Clairechen425/embedded-course-case8/docs/中期检查报告.md

# 中期检查报告

**项目名称**：基于手势识别的智能风扇控制系统  
**报告日期**：2026-07-05  
**小组成员**：3124009587 关博仁、3224004799 陈佩欣

---

## 一、物料到位总览

### 1.1 已到位的物料

| 序号 | 物料名称 | 型号/规格 | 数量 | 用途 | 到位状态 |
|---|---|---|---|---|---|
| 1 | Orange Pi AIpro | 开发板 | 1 | 上位机，运行 HaGRID YOLO 手势识别推理 | 已到位 |
| 2 | STM32F103C8T6 | 最小系统板 | 1 | 下位机，接收手势指令并控制执行器 | 已到位 |
| 3 | USB 摄像头 | 免驱 USB | 1 | 实时手势图像采集 | 已到位 |
| 4 | SG90 舵机 | 9g 微型舵机 | 2 | 云台左右/上下摆风 | 已到位 |
| 5 | L298N 驱动模块 | 双 H 桥 | 1 | 130 直流电机驱动 | 已到位 |
| 6 | 130 直流电机 + 风扇叶片 | 3-6V | 1 | 风源输出 | 已到位 |
| 7 | 充电宝 | 5V/2A 输出 | 1 | 系统统一供电 | 已到位 |
| 8 | USB 数据线 | Micro-USB + Type-C | 2 | Pi↔STM32 通信、Pi↔摄像头连接 | 已到位 |

### 1.2 未到位的物料

| 序号 | 物料名称 | 原因 | 影响 | 预计到位时间 |
|---|---|---|---|---|
| — | 无 | — | — | — |

> **结论**：全部物料已到位，无缺料风险。

---

## 二、当前完成进度

### 2.1 已完成工作

| 序号 | 工作内容 | 负责人 | 完成时间 | 备注 |
|---|---|---|---|---|
| 1 | 硬件系统搭建与连线 | 全组 | 前期 | STM32 + L298N + 电机 + 双舵机 + 摄像头全部连通 |
| 2 | 引脚分配与 PWM 参数确定 | 全组 | 前期 | 风扇 TIM3 CH1 (PA6, 1kHz)、舵机 TIM4 CH1/CH2 (PB6/PB7, 50Hz) |
| 3 | USB CDC 通信链路打通 | 软件组 | 前期 | Pi → STM32 JSON 行协议通信正常 |
| 4 | 极简 JSON 解析器 | 软件组 | 前期 | 手写 `json_get_int/float/str` 三个函数，不依赖外部库 |
| 5 | 风扇四档 PWM 调速 | 软件组 | 前期 | 1 档 (25%) / 2 档 (50%) / 3 档 (75%) / 4 档 (100%) |
| 6 | 手势名称映射表 | 软件组 | 前期 | 34 类手势名称与 Python 端对齐 |
| 7 | Pi 端 3 帧消抖机制 | 软件组 | 前期 | GestureDebouncer 类，threshold=3，确认后去重 |
| 8 | PC 端模拟通信测试 | 软件组 | 前期 | PowerShell 直写 COM 口，全部手势指令验证通过 |
| 9 | 手势识别模型部署 | 软件组 | 前期 | HaGRID YOLO 模型在 Orange Pi 上 10Hz 推理 |

### 2.2 进行中工作

| 序号 | 工作内容 | 当前进展 | 剩余工作 | 预计完成 |
|---|---|---|---|---|
| 1 | 双舵机摆风控制 | 已完成上下舵机独立扫描逻辑设计（预判式折返算法），正在 STM32 端集成调试 | TIM4 初始化、主循环中舵机扫描代码集成、联调 | 2026-07-10 |
| 2 | 左右舵机端点卡顿修复 | 已从"先加后判"改为"预判式折返"方案，边界弹离逻辑已设计 | 实际硬件验证预判式方案是否消除端点停顿 | 2026-07-10 |
| 3 | 全关机联动逻辑 | 代码逻辑已设计（fist → 风扇停 + 双舵机回中） | STM32 端集成测试 | 2026-07-12 |

### 2.3 未开始工作

| 序号 | 工作内容 | 说明 |
|---|---|---|
| 1 | 摄像头设备号漂移修复 | 需通过 udev 规则或设备序列号固定 `/dev/videoX` |
| 2 | 130 电机过热保护 | 需在 4 档加入 PWM 软限幅或温控降档逻辑 |
| 3 | 整机联调测试 | Pi + STM32 + 执行器全链路手势控制实测 |
| 4 | 外壳/结构固定 | 云台、电机、开发板的物理固定与走线整理 |
| 5 | 异常恢复机制 | USB 断连重连、手势超时自动待机等 |
| 6 | 验收文档与演示准备 | 演示脚本、操作说明、项目总结 |

---

## 三、硬件调试情况

### 3.1 各模块测试结果

| 模块 | 测试内容 | 测试方法 | 测试结果 | 状态 |
|---|---|---|---|---|
| STM32 最小系统 | 时钟、GPIO、定时器初始化 | STM32CubeMX 生成 HAL 工程，HSE 8MHz → PLL 48MHz | 正常运行 | 通过 |
| USB CDC 通信 | Pi → STM32 数据传输 | Pi 端发送 `{"c":21,"n":"peace","s":0.95}` → STM32 解析后 PC13 LED 闪烁 | 通信稳定，无丢包 | 通过 |
| L298N + 130 电机 | 风扇四档调速 | 串口发送档位指令 → TIM3 PWM → L298N ENA → 电机转速变化 | 四档转速明显区分 | 通过 |
| SG90 舵机 #1 (PB6) | 左右摆风 | 50Hz PWM, CCR 250–1250 对应 0°–180° | 摆动正常，端点有卡顿（见 3.2） | 部分通过 |
| SG90 舵机 #2 (PB7) | 上下摆风 | 50Hz PWM, 独立 tick 控制 | 摆动正常 | 通过 |
| 双舵机协同 | 两轴同时扫描 | 独立 tick 避免互锁 | 节奏无干扰 | 通过 |
| USB 摄像头 | 图像采集 | Orange Pi 上 OpenCV 读取 | 正常，但 /dev/videoX 编号漂移 | 部分通过 |
| Orange Pi AIpro | 10Hz 推理 | HaGRID YOLO 模型 | 10fps 稳定 | 通过 |
| 充电宝供电 | 全系统供电稳定性 | 同时带 Pi + STM32 + L298N + 双舵机 | 正常工作 | 通过 |

### 3.2 遇到的问题与解决措施

| 编号 | 问题描述 | 现象 | 原因分析 | 解决措施 | 状态 |
|---|---|---|---|---|---|
| HW-1 | 左右舵机单侧端点卡顿 | 一端折返丝滑，另一端肉眼可见停顿一个 tick | 旧方案"先加 CCR 再判断越界"，导致舵机在边界值上停留一个周期 | 改为"预判式折返"：先计算 `next = ccr + dir * 2`，若越界则当场计算反弹值，不写边界 CCR | 方案已设计，待硬件验证 |
| HW-2 | 摄像头设备号漂移 | 每次重启后 `/dev/videoX` 编号变化（video0/video1/video2） | Linux 内核枚举 USB 设备的顺序不确定 | 方案 A: 通过 `/dev/v4l/by-id/` 符号链接固定；方案 B: udev 规则绑定设备序列号创建 `/dev/camera` 别名 | 待实施 |
| HW-3 | 130 电机 5V 全速过热 | 4 档 (100% PWM) 持续运行时电机散发焦味 | 130 电机额定电压 3-6V，满占空比长期运行超出散热能力 | 方案 A: 4 档 PWM 软限幅至 85%；方案 B: 加入超时自动降档（连续 4 档 30s → 降至 2 档） | 待实施 |
| HW-4 | 杜邦线接触不良 | 偶发舵机抖动 | 杜邦线插接不可靠 | 用热熔胶固定关键接口，或更换焊接式连接 | 待处理 |

---

## 四、软件调试情况

### 4.1 各功能模块开发进度

#### Pi 端（上位机）

| 模块 | 文件 | 功能 | 进度 | 说明 |
|---|---|---|---|---|
| 手势识别推理 | `hagrid_yolo/` | HaGRID YOLO 模型推理，10Hz | 100% | 基于官方 demo 运行 |
| 消抖发送 | `camera.py` | `GestureDebouncer` 类：3 帧连击确认 + 确认后去重 | 100% | threshold=3，约 300ms 响应延迟 |
| USB 发送器 | `scripts/usb_sender.py` | `USBSender` 类：JSON 行协议，通过 pyserial 发送到 `/dev/stm32` | 100% | 含 100ms 最小间隔 + score<0.5 过滤 |
| 摄像头固定 | — | 解决 /dev/videoX 漂移 | 0% | 待实施 |

#### STM32 端（下位机）

| 模块 | 文件 | 功能 | 进度 | 说明 |
|---|---|---|---|---|
| USB CDC 接收 | `usbd_cdc_if.c` | `CDC_Receive_FS`：按 `\n` 分行，逐字节累积 | 100% | 含 `ReceivePacket` 重新注册 |
| JSON 解析 | `usbd_cdc_if.c` | `json_get_int/float/str` 三个手写函数 | 100% | 不依赖外部库，适配 20KB RAM |
| 手势数据结构 | `gesture.h` | `GestureResult` 结构体 + 全局变量声明 | 100% | 含 class_id, class_name, score, bbox |
| 手势名称表 | `gesture.c` | `GESTURE_NAMES[34]` 数组 | 100% | 与 Python 端 NAMES 对齐 |
| 风扇 PWM 控制 | `main.c` | switch-case 手势→PWM 档位映射 | 100% | 5 组映射覆盖 12 种手势 ID |
| 接收反馈 LED | `main.c` | 收到手势→PC13 亮 100ms | 100% | 便于调试 |
| 双舵机摆风控制 | `main.c` | 预判式折返 + 独立 tick + OK/timeout/like/dislike 手势映射 | 70% | 算法已设计，main.c 集成未完成 |
| 全关机联动 | `main.c` | fist → 风扇停 + 双舵机回中 | 60% | 逻辑已设计，待舵机代码集成后联调 |

### 4.2 已通过的测试用例

| 编号 | 测试项 | 测试方法 | 预期结果 | 实际结果 | 状态 |
|---|---|---|---|---|---|
| TC-1 | USB CDC 通信链路 | Pi 端发送 JSON → STM32 PC13 LED 闪烁 | LED 每次接收后闪烁 100ms | LED 正常闪烁 | 通过 |
| TC-2 | 风扇 1 档 | one 手势 (ID=19) | PWM CCR=250, 25% 占空比 | 电机低速运转 | 通过 |
| TC-3 | 风扇 2 档 | peace 手势 (ID=21) | PWM CCR=500, 50% 占空比 | 电机中速运转 | 通过 |
| TC-4 | 风扇 3 档 | three 手势 (ID=26) | PWM CCR=750, 75% 占空比 | 电机高速运转 | 通过 |
| TC-5 | 风扇 4 档 | four 手势 (ID=15) | PWM CCR=999, 100% 占空比 | 电机全速运转 | 通过 |
| TC-6 | 开机 (palm) | palm 手势 (ID=20) | 风扇启动 | 风扇启动 | 通过 |
| TC-7 | 全关机 (fist) | fist 手势 (ID=14) | PWM CCR=0, 电机停止 | 电机停止 | 通过 |
| TC-8 | 左右摆风开 | ok 手势 (ID=18) | 舵机 #1 开始扫描 | 舵机摆动 | 部分通过 |
| TC-9 | 左右摆风关 | timeout 手势 (ID=6) | 舵机 #1 停止并回中 | 正常回中 | 通过 |
| TC-10 | 上下摆风开 | like 手势 (ID=16) | 舵机 #2 开始扫描 | 正常摆动 | 通过 |
| TC-11 | 上下摆风关 | dislike 手势 (ID=13) | 舵机 #2 停止并回中 | 正常回中 | 通过 |
| TC-12 | Pi 端消抖 | 同一手势持续 3s | 只发送一次 | 只发一次 | 通过 |
| TC-13 | 手势切换响应 | 比出手势后切换 | <500ms 发送新指令 | <500ms | 通过 |
| TC-14 | PC 模拟发送 | PowerShell 写 COM 口 | 全部手势功能可用 | 全部通过 | 通过 |
| TC-15 | 双舵机独立 tick | 同时开左右+上下摆风 | 两轴互不干扰 | 互不干扰 | 通过 |

---

## 五、存在的问题与风险

### 5.1 技术难点

| 编号 | 问题 | 严重程度 | 描述 | 应对方案 |
|---|---|---|---|---|
| T-1 | 左右舵机端点卡顿 | 中 | 旧算法在边界值停留一个 tick，导致肉眼可见停顿 | 预判式折返方案已设计，待 STM32 端集成验证。若仍有卡顿，进一步优化步进粒度或改用定时器中断驱动 |
| T-2 | 摄像头设备号漂移 | 中 | /dev/videoX 每次重启变化，需手动修改配置 | 优先使用 `/dev/v4l/by-id/` 符号链接；备选 udev 规则固定别名 |
| T-3 | 130 电机过热 | 中 | 4 档全速时电机过热有焦味，存在烧毁风险 | 短期：4 档 PWM 上限降至 85%；长期：加入超时自动降档保护 |
| T-4 | 端到端延迟优化 | 低 | Pi 推理 10Hz (100ms) + 消抖 3 帧 (300ms) + 串口传输，总延迟约 400-500ms | 当前可接受；若需优化可降 threshold 至 2 帧或提升推理帧率 |
| T-5 | STM32 Flash/RAM 受限 | 低 | STM32F103C8T6 仅 20KB RAM / 64KB Flash | 当前代码量余量充足（未引入 JSON 库、未使用 RTOS），暂不构成瓶颈 |

### 5.2 风险矩阵

| 风险 | 概率 | 影响 | 等级 | 应对措施 |
|---|---|---|---|---|
| 舵机算法验证不通过 | 低 | 中 | 中 | 备选方案：简化预判逻辑为"小步进 + 快速折返"，牺牲丝滑度换取可靠性 |
| 电机持续过热导致损坏 | 中 | 高 | 高 | 立即实施 PWM 软限幅；准备备用 130 电机 |
| 摄像头漂移导致演示时无法识别 | 中 | 高 | 高 | 本周内完成 udev 固定，演示前提前开机验证 |
| 杜邦线接触不良导致演示中断 | 中 | 中 | 中 | 演示前用热熔胶固定所有关键接口；准备备用杜邦线 |
| Pi 端模型推理异常 | 低 | 高 | 中 | 保留 PC 模拟发送作为演示 backup，确保至少能通过 PC 演示全部功能 |

---

## 六、后续工作计划

### 6.1 至验收前的详细计划

> **第一次验收**：2026-07-09（周四）9:00 — 演示系统功能、现场测试、教师提问与修改意见、提交阶段性成果（功能演示视频、测试数据记录）  
> **第二次验收**：2026-07-10（周五）9:00 — 根据第一次验收意见改进后再次验收，最终评定成绩

| 日期 | 时段 | 工作内容 | 交付物 |
|---|---|---|---|
| **07.06**（周日） | 全天 | **舵机集成冲刺** | |
| | | STM32 端集成双舵机预判式折返代码 + TIM4 初始化 | 可编译固件 |
| | | 全关机联动逻辑 (fist → 风扇停 + 舵机回中) 集成到 main.c | 可编译固件 |
| | | 摄像头 udev 规则编写 + /dev/v4l/by-id/ 固定验证 | udev 配置文件 |
| | | 4 档 PWM 软限幅至 85% | 可编译固件 |
| **07.07**（周一） | 全天 | **联调 + 问题修复** | |
| | | Pi + STM32 + 执行器全链路联调 | 联调通过 |
| | | 所有 14 项测试用例端到端复测 | 测试记录表 |
| | | 左右舵机预判式折返硬件验证 | 验证记录 |
| | | 结构固定：云台、电机、开发板定位 + 走线整理 | 整洁实物 |
| | | 杜邦线关键接口热熔胶固定 | 可靠连接 |
| **07.08**（周二） | 全天 | **演示准备** | |
| | | 验收演示脚本编排 + 排练（覆盖全部 12 种手势动作） | 演示流程文档 |
| | | 拍摄功能演示视频 | 演示视频 |
| | | 整理测试数据记录 | 测试数据文档 |
| | | 电机过热保护（超时自动降档） | 可编译固件 |
| | | 代码整理、注释补充、README 编写 | 代码仓库 |
| | | 中期检查报告最终定稿 | 本报告 |
| **07.09**（周三） | 上午 9:00 | **第一次验收** | 功能演示 + 视频 + 测试数据 |
| | 下午 | 根据教师反馈意见逐项修改 | 问题修复记录 |
| | | USB 断连自动恢复机制（若时间允许） | 可编译固件 |
| **07.10**（周四） | 上午 9:00 | **第二次验收（最终评定）** | 改进后系统 + 全部文档 |

### 6.2 分工调整

| 成员 | 原分工 | 调整后分工 | 调整原因 |
|---|---|---|---|
| 关博仁 | — | 负责 STM32 端舵机集成 + 保护逻辑 + 硬件结构固定 | 按计划执行 |
| 陈佩欣 | — | 负责 Pi 端摄像头固定 + 全链路联调 + 演示准备 | 按计划执行 |

### 6.3 关键里程碑

```
07.06 ── 舵机代码集成完成 + PWM 软限幅 ── 具备联调条件
07.07 ── 全链路联调通过 + 14 项测试复测 ── 系统功能完整
07.08 ── 演示视频拍摄完成 + 文档定稿 ── 提交物就绪
07.09 9:00 ── 第一次验收 ── 功能演示 + 教师反馈
07.09 下午 ── 根据反馈修改 ── 问题清零
07.10 9:00 ── 第二次验收（最终评定） ── 最终成绩
```

---

## 七、附录

### 7.1 硬件连接总览

```
                    ┌─────────────────────────────────────┐
                    │          Orange Pi AIpro              │
                    │  HaGRID YOLO 10Hz 推理                │
                    │  GestureDebouncer 消抖                │
                    │  USBSender → /dev/stm32               │
                    └──────┬──────────┬────────────────────┘
                 USB 摄像头  │          │ USB CDC (Micro-USB)
                            │          │
                    ┌───────┴──────────┴────────────────────┐
                    │           STM32F103C8T6                │
                    │  USB CDC 接收 → JSON 解析 → 手势执行   │
                    │                                        │
                    │  PA6 ── PWM ── L298N ENA (风扇调速)    │
                    │  PB3 ── GPIO ── L298N IN1 (方向)       │
                    │  PB4 ── GPIO ── L298N IN2 (方向)       │
                    │  PB6 ── PWM ── SG90 #1 (左右摆风)      │
                    │  PB7 ── PWM ── SG90 #2 (上下摆风)      │
                    │  PC13 ── LED (接收反馈)                │
                    └───────────────────────────────────────┘
                                      │
                              ┌───────┴───────┐
                              │    充电宝 5V   │
                              └───────────────┘
```

### 7.2 通信协议

```
物理层:  USB 2.0 Full Speed, D+/D- 差分信号
链路层:  USB CDC ACM (Virtual COM Port, BULK OUT endpoint)
应用层:  JSON 行协议, '\n' 分隔

下行 (Pi → STM32):
  {"c":21,"n":"peace","s":0.95}
  c: class_id (手势编号 0-33)
  n: class_name (手势名称)
  s: score (置信度 0-1)

Pi 端消抖: 3 帧连击确认 (~300ms), 确认后相同 ID 不重复发送
STM32 端: 直接解析执行, 无需回传确认
```

### 7.3 手势-动作映射表

| 手势 | ID | 动作 | PWM 参数 | 状态 |
|---|-----|---|---|---|
| palm | 20 | 开机 → 1 档 (25%) | CCR=250 | 已通过 |
| stop | 24 | 同 palm | CCR=250 | 已通过 |
| fist | 14 | 全关：风扇停 + 舵机回中 | CCR=0 | 调试中 |
| one | 19 | 1 档 (25%) | CCR=250 | 已通过 |
| peace / peace_inverted / two_up / two_up_inverted | 21/22/28/29 | 2 档 (50%) | CCR=500 | 已通过 |
| three / three2 / three3 / three_gun | 26/27/5/30 | 3 档 (75%) | CCR=750 | 已通过 |
| four | 15 | 4 档 (100%) | CCR=999 | 已通过 |
| ok | 18 | 左右摆风开 | — | 调试中 |
| timeout | 6 | 左右摆风关 + 回中 | — | 已通过 |
| like | 16 | 上下摆风开 | — | 已通过 |
| dislike | 13 | 上下摆风关 + 回中 | — | 已通过 |

---

> **报告撰写日期**：2026-07-05
