Clairechen425/embedded-course-case8/code/stm32/fan_test.ioc

Mcu.UserName=STM32F103C8Tx
PA11.Signal=USB_DM
PA12.Signal=USB_DP
PA13.Signal=SYS_JTMS-SWDIO
PA14.Signal=SYS_JTCK-SWCLK
PA6.Signal=S_TIM3_CH1
PB3.Signal=GPIO_Output
PB4.Signal=GPIO_Output
PB6.Signal=S_TIM4_CH1
PB7.Signal=S_TIM4_CH2
PC13-TAMPER-RTC.Signal=GPIO_Output
PD0-OSC_IN.Signal=RCC_OSC_IN
PD1-OSC_OUT.Signal=RCC_OSC_OUT
