Clairechen425/embedded-course-case8/(commit log)

2026-07-02 新增系统方案设计课设报告文档
    存放昇腾310B手势识别控制系统完整设计文档，包含物料清单、系统架构、软硬件详细设计、项目进度规划，用于课程设计提交。
2026-07-05 Add files via upload
    新增中期检查报告到docs文件夹
2026-07-05 create code/stm32 directory
    Add a temporary placeholder file for directory structure.
2026-07-05 create fan subfolder for fan control code
2026-07-10 增加项目功能报告书
    增加项目功能报告书
